aryajisantosa/iot-fish-temp-control/docs/images/firmware/arduino-ide-serial-monitor.png

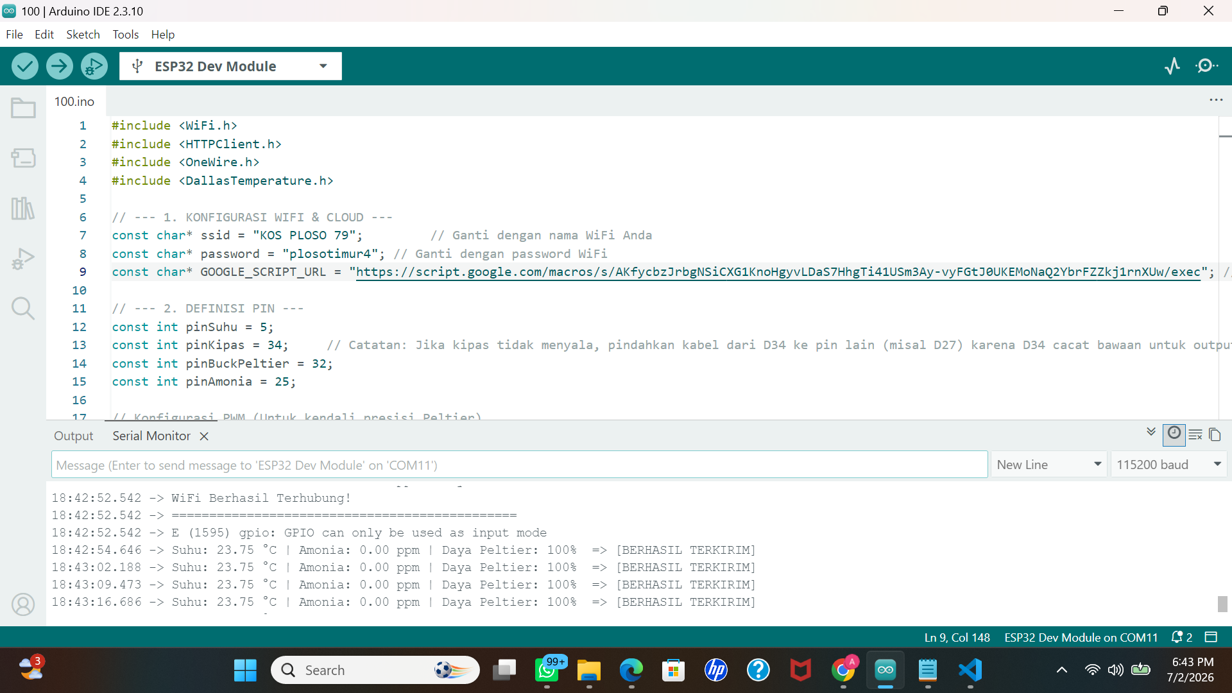
docs/images/firmware/arduino-ide-serial-monitor.png
