aryajisantosa/iot-fish-temp-control/docs/images/firmware/source-code.png

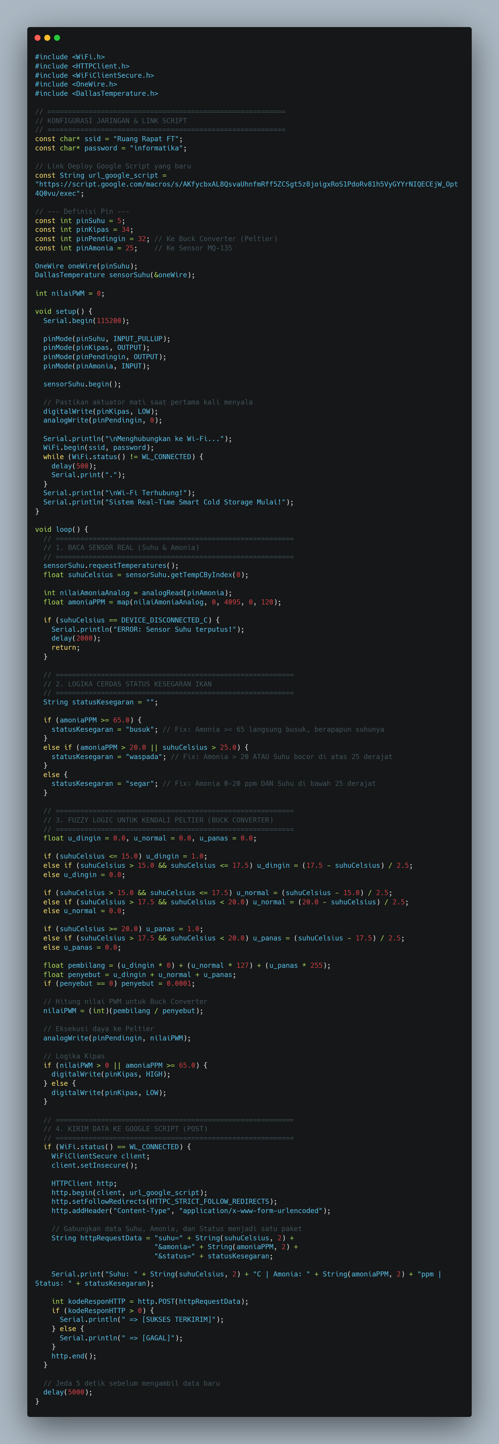
docs/images/firmware/source-code.png
